alectsnodgrass/Project-HELIOS/README.md

# **Project HELIOS**

> [!NOTE]
> Project HELIOS takes its name from Helios, the Greek personification of the Sun. In ancient mythology, Helios commanded a magnificent chariot of fire, drawn by four powerful horses, carrying the Sun across the heavens each day.
> 
> His legendary journey symbolizes the union of solar energy, power, and motion. Just as Helios harnessed the power of the Sun to drive his celestial chariot, Project HELIOS seeks to harness solar energy to power modern vehicles.
HELIOS

# Executive Summary

### Elevator Pitch

Project HELIOS transformed an incomplete, nonoperational golf cart into a working platform for evaluating solar-assisted electric transportation. In partnership with LANI-EV, a division of LANI-Solar, the team restored Tennessee Tech’s Club Car, integrated a lithium iron phosphate battery and solar-charging system, and evaluated how solar energy replenishes the battery relative to vehicle energy use. The project also produced an adaptable solar-panel mounting kit and a simulated four-servo control concept that directs the panel toward the sun while the cart is parked. Together, these outcomes provide practical designs, performance evidence, and repeatable documentation to support future solar-powered vehicle retrofits.

### Abstract

Solar-assisted low-speed vehicles offer an opportunity to supplement grid charging with onboard renewable energy. Their practical value depends on reliable integration, adaptable mounting hardware, and an understanding of how solar generation compares with vehicle energy demand. Working with LANI-EV, Tennessee Technological University’s Electrical and Computer Engineering Project HELIOS addressed these challenges through vehicle restoration, retrofit implementation, performance testing, and control-system design.

The team restored an inherited Club Car that arrived partially disassembled and without batteries or a steering wheel. A lithium iron phosphate battery and solar-charging system were integrated, supported by an illustrated conversion procedure, as-built electrical documentation, and installation records. Post-conversion testing characterized solar charging and vehicle discharge under documented operating conditions, providing an evidence-based assessment of the system’s energy balance.

To improve installation adaptability, the team surveyed roof configurations across three major vehicle brands and developed a functional mounting-kit prototype designed to accommodate selected models from at least two brands. The team also developed and evaluated a concept for parked-vehicle solar tracking. Using vehicle-state, solar optics, and position tracking the algorithm generated coordinated commands for four servos within a modeled range of panel motion. Simulation evaluated orientation calculations, operating-state transitions, and responses to invalid inputs.

The completed project delivered a restored demonstration vehicle, retrofit documentation, performance data, a mounting-kit engineering package, and a simulated solar-tracking concept. These deliverables establish a foundation for LANI-EV and future engineering teams to refine solar-assisted vehicle designs and assess their suitability for specific operating conditions.

# Capabilities

The completed project combines a solar-assisted vehicle retrofit, adaptable mounting hardware, and a maximum power point solar-tracking concept.

 - **Operational vehicle platform:** A restored Tennessee Tech Club Car supports demonstration and testing of the LANI-EV solar retrofit.

 - **Solar-assisted battery charging:** A lithium iron phosphate (LiFePO₄) battery and compatible solar-charging system supply vehicle power and replenish stored energy when sunlight is available.

 - **Performance characterization:** Recorded charging and discharge data show how solar input compares with vehicle energy demand under documented operating conditions.

 - **Adaptable panel mounting:** A functional mounting-kit prototype provides a common attachment approach designed for selected models from at least two major vehicle brands. Engineering drawings and installation instructions define its supported configurations.

 - **Simulated solar tracking:** A control algorithm uses vehicle-state, compass-heading, date/time, and geographic-location inputs to calculate panel orientation and generate coordinated commands for four servos. Simulation covers parked-operation logic, motion limits, and invalid-input handling.

 - **Repeatable engineering documentation:** Conversion instructions, wiring diagrams, component records, test procedures, and editable design files support maintenance and future development.

Full-scale powered panel positioning remains a future implementation step. Solar charging supplements the battery’s energy supply; grid-free operation depends on sunlight, driving conditions, and vehicle usage.

# Salient Outcomes

 - Restoration became a substantial engineering contribution. The inherited vehicle arrived disassembled, without batteries or a steering wheel, and with extra, unnecessary components. Establishing a functional test platform required evaluating and restoring the vehicle before completing the retrofit.

 - The project connected solar generation to actual vehicle demand. Charge-versus-discharge testing provided a practical basis for evaluating solar assistance under specific operating conditions.

 - The mounting design addressed more than one vehicle configuration. A three-brand roof survey informed an adaptable kit architecture, with shared components and model-specific interfaces documented for future refinement.

 - Parked time became an opportunity for further design exploration. The tracking concept explored how panel orientation could follow the sun while the vehicle is stationary. 

 - The documentation supports continued development. The project leaves future teams with a traceable record of the vehicle configuration, installation process, test results, and design assumptions.

# Project Demonstration & Images

Give a link to a video of the project being demonstrated. The video should be hosted on the capstone youtube.

# About Us

### Alec Snodgrass 
Alec Snodgrass will graduate Fall 2026 with a B.S. in both in Electrical Engineering and Physics. Serving as the team lead for this capstone project, he is responsible for project management, external communication with the industry sponsor, and oversight of subsystems integration. His prior physics research capstone experience contributes to structured experimental design, data analysis, and methodology development. In addition to managerial responsibilities, he maintains equal technical contribution. His prior military leadership experience informs his organizational approach and accountability standards in managing a multi-member engineering team.

### George Vaporis  
George Vaporis is a senior at Tennessee Technological University, majoring in Electrical Engineering. He is responsible for completing all tasks assigned in a manner of good quality and timeliness. He has previous experience in working in group projects that have involved coding, building, and information gathering and analysis, giving him the necessary experience to complete any tasks assigned for this project.

### Landon Paul  
Landon Paul is a senior majoring in Electrical Engineering, with a minor in Mathematics. As secretary for this project, his responsibilities include documenting and distributing information for each team meeting. While in high school, Landon graduated Summa Cum Laude with an associate degree in Liberal Arts from Austin Peay State University through the dual enrollment program. He began working for his father’s company at age 12, fulfilling projects for customers such as the Country Music Hall of Fame, the Tennessee Titans, and Taylor Swift. While at Tennessee Tech, he has had the privilege to be a tutor, grader, and a teacher’s assistant.

### Nathan Galloway 
Nathan Galloway is a senior at Tennessee Technological University pursuing a Bachelor of Science in Electrical Engineering with a concentration in power systems. Throughout his academic career, Nathan has developed a strong foundation in power analysis, programming, and hands-on electrical systems work; skills he will bring directly over to this project. In his role, Nathan will be responsible for collecting and analyzing project data, then synthesizing his findings into a clear, well-organized, and professional document. He will also contribute to the hands-on restoration of the golf car, working to return it to fully operational condition.

### Parker Branson
Parker Branson is a senior in Electrical Engineering and has an associate's degree in mathematics and physics. My main focus is in power systems and my contribution to the project will be to bring in knowlege to the team to help complet task and while ensuring to carry my full share of the responsibilities we take on as a group and also hands on work with the golf car. Parker is experienced in electrical wiring, Excel, C++, soldering, and LTspice. 

---

## Faculty Supervisor -- Dr. Charles Van Neste

| Field | Information |
|---|---|
| **Title** | Associate Professor |
| **Department** | Electrical and Computer Engineering |
| **Office** | Prescott Hall (PRSC) 407 |
| **Email** | cvanneste@tntech.edu |
| **Phone** | (931) 372-3682 |

### Research Areas and Interests

| Research Area |
|---------------|
| Alternative forms of energy generation and transmission (wireless and quasi-wireless power transfer) |
| High frequency inverter design |
| Electronic instrumentation |
| Electromagnetic interactions |

### Educational Background

| Degree / Position | Institution | Year | Notes |
|---|---|---|---|
| Postdoctoral Research | Oak Ridge National Laboratory | 2010 | Photonics |
| Ph.D. Electrical Engineering | Tennessee Tech University / ORNL | 2009 | Thesis: *The Sound of Light: An open environment photoacoustic identification of surface adsorbed molecules* |
| M.S. Electrical Engineering | Tennessee Tech University / ORNL | 2006 | Research Assistantship |
| B.S. Electrical Engineering | Tennessee Tech University | 2004 | Undergraduate |

---

## Stakeholders
The primary customer for this project is Lani Electric Vehicles (LaniEV), a subsidiary of Lani Solar, LLC. Lani Solar develops solar-integrated mobility platforms and energy solutions intended to reduce grid dependence and lifecycle operating costs in light electric vehicle applications. LaniEV is developing standardized retrofit conversion kits for low-speed electric vehicles (LSVs), personal transportation vehicles (PTVs), and golf cars that replace legacy lead-acid battery systems with LiFePO₄ battery banks integrated with solar charging capability. The company’s objective is to enable scalable fleet conversions by providing a structured and repeatable retrofit platform supported by validated engineering documentation.

Secondary stakeholders include organizations that utilize LSV fleets, such as golf resorts, hotels, universities, airports, and industrial plants. Organizations such as these rely on LSVs for day-to-day logistics and are directly affected by reliability, lifecycle cost, and maintenance requirements. Formal documentation of the retrofit process and post-conversion performance data provides decision-making support for these stakeholders by enabling informed evaluation of economic and operational impact. Secondary stakeholders also include Tennessee Technological University (TTU), as the owner of the control golf car used for the project, and as the ensuring agency for documented safety, reliability, and performance data. Dr. Christopher Storm Johnson is responsible, as the capstone instructor, for evaluating team performance and ensuring the project's desired end-state is reached.

---

# Repo Organization

### 1. Reports

    Poster Template
    Report Figures
    0. Team 6 Contract
    1. Project Proposal Specification
    2. Conceptual Design Specifications
    3. Detailed Design Specifications
    4. Design Presentation Specifications
    5. Experimental Analysis Specifications
    6. Individual Presentation Specifications
    7. Final Presentation Specifications
    8. Final Poster Specifications

### 2. Documentation

    0. Project Details
        - Club Car Manuals
        - Rubrics
        - Standards
        - Team 1 Project Outline
        - Team 6 Project Outline
        - Project Timeline
    1. Photos
        - 0. Initial State of LSV
        - 1. Conversion Process
        - 2. Post-conversion
    2. Electrical
        - PCB
        - Schematics
    3. Software
    4. Mechanical
        - CAD Parts
        - Cad Assemblies
        - Chinese Drawings

### 3. Meeting Minutes

    Meeting Minutes Week 1
    Meeting Minutes Week 2
    Meeting Minutes Week 3
    Meeting Minutes Week 4
    Meeting Minutes Week 5
    Meeting Minutes Week 6
    Meeting Minutes Week 7
    Meeting Minutes Week 8
    Meeting Minutes Week 9
    Meeting Minutes Week 10
    Meeting Minutes Week 11
    Meeting Minutes Week 12
    Meeting Minutes Week 13
    Meeting Minutes Week 14
    Meeting Minutes Week 15
    Meeting Minutes Week 16
    Meeting Minutes Week 17
    Meeting Minutes Week 18
    Meeting Minutes Week 19
    Meeting Minutes Week 20
    Meeting Minutes Week 21
    Meeting Minutes Week 22
