alectsnodgrass/Project-HELIOS/2. Documentation/3. Software/Solar_Tracker/tinkercad.md

# Circuit Design for Solar Tracker

[Tinkercad](https://www.tinkercad.com/things/2MzcQUdWTNI-solar-tracking-code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)
