alectsnodgrass/Project-HELIOS/2. Documentation/0. Project Details/Team 1 Project Outline/Team1_Original Project Specs.pdf

TTU Capstone Project Write-Up

Proposed Project Title: Integrated Solar Power System for Low-Speed Vehicles (LSVs): Advancing Technology, Economics, and Design

Proposed Starting Semester: Spring Semester January 16, 2026.

Introduction and Motivation (Project Purpose: Describe problem/opportunity with current product or situation)

This capstone project, in collaboration with Lani EV, LLC, aims to accelerate the transition of Low-Speed Vehicles (LSVs) toward self-sustaining solar power. As the LSV market seeks greater operational efficiency and sustainability, this study addresses four critical areas: advanced solar technology feasibility, economic validation, engineering design, and battery management system integration. The findings will provide objective, data-driven validation for a new generation of solar-powered LSVs.

Alignment with TTU Research

The central hypothesis is that this unit can sustain operation for several weeks without requiring grid-based charging via the on-board charger. We therefore seek independent, objective evaluation and analysis to validate this claim. Furthermore, we hypothesize that the societal benefits of this technology—such as reducing strain on the electrical grid and lowering carbon emissions—will translate into measurable economic gains. The research expertise of Tennessee Tech University is essential to rigorously quantify these environmental and societal impacts.

The successful project will provide the candidate with experience in applying the scientific method to a real-world engineering problem. The candidate will be responsible for defining the critical performance metrics and designing the experimental protocol for measurement and documentation. This work requires developing both qualitative and quantitative methods to compare the operational characteristics of gas versus solar/battery power sources.

A primary output will be documentation showing the solar cart’s self-sustaining capability under average daylight conditions. Specifically, a detailed data table will be required to plot the LiFePO4 battery's charge and discharge rates across varying solar irradiance (measured in foot-candles or W/m2) and corresponding motor amp draw (representing speed and load)

Project Objectives (Summary) (Goals and Objectives: What must the product or research achieve? What are the project objectives and specifications for the final product / process?)

Comparative Economic & Performance Analysis: Quantify the life-cycle cost savings and document the operational performance (range, efficiency) of solar-powered carts vs. gas and traditional electric carts.

Universal Solar Panel Attachment Kit Development: Design, model, and prototype a non-invasive, universal kit to adapt solar panels to major name-brand LSV roofs.

Solar Integration and BMS Investigation: Study the dynamic interaction and impact of continuous solar charging on the Battery Management System (BMS) of a LiFePO₄ battery.

Advanced Solar Technology Feasibility: Evaluate and model the application of next-generation solar cells (TOPCon, Perovskite) and flexible PV (Photovoltaic) on LSVs to determine efficiency gains over standard PV.

Deliverables

Comprehensive White Paper: A final report detailing the methodology, data, conclusions, and recommendations across all four objectives.

Engineering Package: Computer-Aided Design (CAD) files, engineering drawings, and a fabricated prototype of the universal attachment kit (O3).

Performance Data Logs: Raw and summarized data on solar charging dynamics, comparative cart performance, and LiFePO₄ BMS parameters (O2 & O4).

Economic Analysis Report: Detailed cost-savings analysis and return on investment (ROI) calculation (O2).

Goal 1: Comparative Economic & Performance Analysis

Objective: To establish a verifiable baseline for the economic and operational advantages of a solar cart over traditional electric and gas-powered LSVs across varied conditions and terrains.

Goal Description | Deliverable
G1.1 - Cost Baseline Development: Quantify and compare the initial investment, maintenance, and operational costs (e.g., fuel/electricity cost per mile, labor for refueling) for solar, electric, and gas carts. | Full Life-Cycle Cost Comparison Table.
G1.2 - Range Testing Methodology: Develop a rigorous methodology to measure the distance a solar-charged battery can travel until a defined depletion point under diverse terrains (flat, hilly) and environmental conditions. | Detailed Test Protocol (Methodology Section).
G1.3 - Performance Documentation: Execute the methodology (G1.2) and document key | Comparative Performance Graphs.

performance metrics, including Cost Per Mile and Energy Consumption Per Mile, for all three cart types.

G1.4 - Economic ROI Analysis: Document and analyze the baseline cost savings and calculate the Return on Investment (ROI) timeframe for the solar cart compared to the alternatives. | Economic Savings White Paper Section.

Goal 2: Advanced Solar Technology Feasibility & Application

Objective: To examine the efficacy of the most recent advanced solar applications (e.g., TOPCon, Perovskite, Smart Panels, Flexible PV) and determine their technical and efficiency benefits when applied to Low-Speed Vehicles (LSVs).

Goal Description | Deliverable
G2.1- Literature Review: Conduct a comprehensive review of the latest solar cell technologies (TOPCon, Perovskite Tandem Cells, Smart Panels with Microinverters) focusing on power density, conversion efficiency, and cost per watt. | Research Report on Advanced Solar PV.
G2.2 - Efficiency Gap Analysis: Quantify the theoretical efficiency increase of these advanced technologies compared to standard Photovoltaic (PV) cells relevant to the LSV application. | Comparative Efficiency Data Table.
G2.3 - Flexible PV Testing: Design and execute bench testing to measure the charge contribution (Delta V charge) of a flexible solar application to a specified battery (e.g., LiFePO₄) under controlled light and temperature conditions. | Flexible Solar Performance Data Log.
G2.4 - LSV Application Modeling: Develop a simulation model applying the findings (G1.2) to an LSV, estimating the resulting increase in range or decrease in grid charging frequency. | Applied LSV Performance Model.

Goal 3: Universal Solar Panel Attachment Kit Development

Objective: To design and prototype a universal, non-invasive attachment mechanism (kit) that allows a solar panel to be reliably and aesthetically fitted to multiple major brand LSVs (e.g., EZ GO, Yamaha).

Goal Description | Deliverable
G3.1- Design Requirements Definition: Survey and document the dimensional and structural specifications (e.g., roof size, mounting points, material) of the top three name-brand LSV roofs (e.g., EZ GO, Yamaha, Club Car). | LSV Roof Specification Matrix.
G3.2 - Universal Design Concept: Develop a CAD model of a solar panel mounting kit that can be adapted to fit at least two different name-brand LSVs while prioritizing non-invasive installation and aerodynamic stability. | CAD Design Renders and Part List.
G3.3 - Prototype Fabrication: Fabricate a functional prototype of the universal attachment kit using suitable materials. | Physical Prototype Kit.
G3.4 - Installation Manual: Document the installation process for the attachment kit, providing clear instructions for adaptability across different models. | Engineering Drawings and Installation Guide.

Goal 4: Solar Integration and Battery Management System (BMS) Investigation

Objective: To investigate the interface between solar charging and the Battery Management System (BMS) of a LiFePO₄ battery, assessing how a solar roof manages the charge and its overall impact on battery health.

Goal Description | Deliverable
G4.1- BMS Communication Analysis: Document the specific charge management protocols (e.g., float voltage, cutoff parameters) and data communication methods used by the existing solar charge controller and the LiFePO₄ BMS. | System Integration Diagram and Protocol Summary.
G4.2 - Controlled Charge Impact Study: Conduct a long-term (e.g., 30-day) study | Long-Term Battery Health Data.

where a LiFePO₄ battery is continuously solar-charged. Monitor and document key BMS parameters (e.g., cell balancing, temperature, State of Health (SOH)) versus a baseline battery.

G4.3 - Battery Technology Forecast: Research and document the latest technical battery advances (e.g., solid-state, next-gen Li-ion) and provide a technical forecast on how they will interact with or necessitate changes to the solar roof's charge management system. | Technical Forecast Report.
G4.4 - Optimal Integration Recommendation: Based on findings, provide a set of recommendations for optimizing the solar charge controller settings to maximize battery life and performance. | Integration Recommendation Summary.

Conclusion

This capstone project outlines a symbiotic partnership between Lani EV, LLC and Tennessee Tech University, designed to rigorously quantify the real-world performance, economic viability, and societal impact of a novel solar-powered low-speed vehicle.

For the TTU capstone candidate, this project offers an exceptional opportunity to apply the scientific method and advanced engineering principles to a tangible, real-world challenge. The candidate will gain direct experience in experimental design, data analysis, and the
development of both qualitative and quantitative metrics, while also building upon the research foundation of previous TTU capstone projects.

For Lani EV, LLC this collaboration provides the critical, independent validation necessary to move the assessment of this technology from an internal hypothesis to an objectively verified fact. The resulting data will be transformative, providing objective proof (or disproval) of the solar cart's extended operational efficiency, its return on investment, and its potential as a transformative, attainable benefit to society.

We are confident that this study will yield significant insights, culminating in a comprehensive white paper that details technology’s true capabilities. We look forward to collaborating with Tennessee Tech University to execute this timely and impactful research.

Components Needed for Hypothesis Validation and Self-Sustaining Capability Demonstration (Grok.com)

To validate the central hypothesis (sustained operation for weeks without grid charging) and produce the required documentation (e.g., data tables plotting LiFePO4 battery charge/discharge rates vs. solar irradiance and motor amp draw), the following core components are essential for setup, testing, and data collection. These enable experimental protocols comparing gas vs. solar/battery power sources under average daylight conditions.

Solar-Powered LSV Base System:

Low-Speed Vehicle (LSV) or golf cart chassis (e.g., 36V or 48V system, compatible with major brands like EZGO, Club Car, Yamaha).

LiFePO4 battery pack (e.g., 100Ah or higher capacity, with built-in or external BMS for safe charging/discharging).

Solar panels (standard monocrystalline or polycrystalline PV, 100W–410W rating, flexible for roof mounting to simulate real-world integration).

MPPT solar charge controller (to optimize continuous solar input and prevent overcharging).

Electric motor and controller (brushless DC type, rated for variable speeds and loads).

Wiring harness, fuses, and connectors (for integrating solar input to battery and motor).

Measurement and Data Logging Tools:

Solar irradiance meter (e.g., Fluke IRR1-SOL or REED R8180, measuring in W/m² or foot-candles up to 2000 W/m²).

Clamp meter or multimeter (e.g., Fluke models for amp draw, voltage, and current monitoring during motor operation and battery cycles).

Battery monitoring sensors (voltage, current, temperature probes to track charge/discharge rates and BMS parameters).

Data logger (e.g., portable USB or Bluetooth-enabled device for real-time logging of irradiance, amp draw, and battery metrics over extended periods).

Pyranometer (for precise solar radiation measurement in outdoor tests).

Comparative Test Vehicles:

Gas-powered cart (e.g., standard gasoline engine model for baseline performance metrics like fuel consumption and range).

Traditional electric cart (grid-charged, with lead-acid or basic lithium batteries for efficiency and range comparison).

These components allow qualitative (e.g., operational observations) and quantitative (e.g., efficiency calculations) methods, with data outputs for tables and plots.

Components for Objective 1: Comparative Economic & Performance Analysis

To quantify life-cycle cost savings, range, and efficiency of solar-powered carts vs. gas and traditional electric carts, additional specialized items are needed beyond the base system.

Performance Testing Equipment:

Odometer or GPS tracker (for measuring range under varying loads and speeds).

Energy consumption meter (e.g., for kWh usage in electric/solar vs. fuel volume in gas carts).

Dynamometer or load simulator (to mimic real-world speeds and inclines for amp draw and efficiency tests).

Economic Analysis Tools:

Spreadsheet software or dedicated modeling tools (e.g., Excel with add-ins for ROI calculations, incorporating fuel/electricity costs, maintenance, and carbon emissions data).

Environmental sensors (e.g., CO2 emission analyzer for gas carts to quantify carbon footprint mitigation).

This setup supports side-by-side field evaluations, showing solar carts can extend range by 3–7 miles per charge and reduce energy use by up to 20% annually compared to grid-electric or gas models.

Components for Objective 2: Universal Solar Panel Attachment Kit Development

For designing, modeling, and prototyping a non-invasive, universal kit adaptable to major LSV roofs.

Design and Modeling Tools:

CAD software (e.g., SolidWorks or AutoCAD for creating drawings and 3D models).

3D printer or CNC machine (for rapid prototyping of custom parts).

Hardware Components for Prototype:

Z-brackets or L-brackets (aluminum or steel, with nuts, bolts, and washers for secure mounting).

Adjustable clamps or crab mounts (non-drilling type for roof rails or crossbars, compatible with curved or flat LSV roofs).

Tilt legs or adjustable rails (e.g., 58-inch foldable mounts for angle optimization).

Adapters and spacers (rubber or foam padding to fit brands like EZGO, Club Car, or Bintelli without damage).

Fasteners and hardware kit (M6 hex cap bolts, screws, and anti-vibration mounts).

The kit emphasizes ease of installation, with all parts included for roof/wall mounting, ensuring compatibility across vehicle types.

Components for Objective 3: Solar Integration and BMS Investigation

To study the dynamic interaction of continuous solar charging on LiFePO4 BMS.

Battery and Charging System:

LiFePO4 battery cells (individual or pack, e.g., 3.2V cells in series for 12V–48V configurations).

Dedicated BMS module (with overcharge/overdischarge protection, current monitoring, and temperature sensors).

Continuous solar charger (e.g., PWM or MPPT controller simulating daylight input).

Monitoring and Testing Tools:

Oscilloscope or power analyzer (to observe voltage drops, current fluctuations, and BMS responses during charging).

Thermal imager (e.g., Fluke model to detect overheating risks from constant 14.4V input).

Cycle tester (for repeated charge/discharge simulations to assess lifespan impact).

Components ensure safe operation, preventing issues like overcurrent or imbalance, with data showing efficiencies up to 98% in solar setups.

Components for Objective 4: Advanced Solar Technology Feasibility

To evaluate and model next-generation solar cells (TOPCon, Perovskite, flexible PV) on LSVs for efficiency gains over standard PV.

Advanced Solar Panels:

TOPCon solar cells (high-efficiency silicon-based, for baseline comparisons).

Perovskite solar cells (tandem or standalone, lightweight and flexible for vehicle integration).

Flexible PV modules (e.g., CIGS or thin-film, bendable for curved roofs).

Evaluation Tools:

Efficiency tester (e.g., solar simulator or outdoor irradiance setup to measure power conversion up to 31%).

Modeling software (e.g., PVsyst or MATLAB for simulating gains, predicting 10–30% improvements over standard PV).

Mounting adapters (to test integration on LSV roofs without permanent changes).

These enable modeling of real-world applications, highlighting perovskite's potential for lightweight, high-efficiency (up to 31%) flexible cells.

Additional Resources for Deliverables

Documentation and Reporting Tools: Word processors or LaTeX for white papers; data visualization software (e.g., MATLAB, Python with Matplotlib) for charts and logs.

Fabrication Support: Workshop tools (drills, saws) for prototype assembly; raw materials like aluminum sheets for custom brackets.

These components collectively enable rigorous quantification of environmental/societal benefits (e.g., reduced grid strain, lower emissions) and economic advantages (e.g., ROI from 20% energy savings), aligning with Tennessee Tech's research expertise. Procurement should prioritize US-made items where possible for reliability.
