alectsnodgrass/Project-HELIOS/2. Documentation/0. Project Details/Team 1 Project Outline/Team1_Updated Project Specs.pdf

Goal 1: Comparative Economic & Performance Analysis

Objective: To establish a verifiable baseline for the economic and operational advantages of a solar cart over traditional electric and gas-powered LSVs across varied conditions and terrains.
Goal Description | Deliverable
G1.1 - Cost Baseline Development: Quantify and compare the initial investment, maintenance, and operational costs (e.g., fuel/electricity cost per mile, labor for refueling) for solar, electric, and gas carts. | Full Life-Cycle Cost Comparison Table.

G1.2 - Range Testing Methodology: Develop a rigorous methodology to measure the distance a solar-charged battery can travel until a defined depletion point under diverse terrains (flat, hilly) and environmental conditions.

Detailed Test Protocol (Methodology Section).

G1.3 - Performance Documentation: Execute the methodology (G1.2) and document key performance metrics, including Cost Per Mile and Energy Consumption Per Mile, for all three cart types. | Comparative Performance Graphs.
G1.4 - Economic ROI Analysis: Document and analyze the baseline cost savings and calculate the Return on Investment (ROI) timeframe for the solar cart compared to the alternatives. | Economic Savings White Paper Section.

Goal 2: Advanced Solar Technology Feasibility & Application

Objective: To examine the efficacy of the Perovskite and determine its technical and efficiency benefits when applied to Low-Speed Vehicles (LSVs).
Goal Description | Deliverable
G2.1- Literature Review: Conduct a comprehensive review of Perovskite focusing on power density, conversion efficiency, and cost per watt. | Research Report on Perovskite.
G2.2 - Efficiency Gap Analysis: Quantify the theoretical efficiency increase Perovskite. compared to standard Photovoltaic (PV) cells relevant to the LSV application. | Comparative Efficiency Data Table.
G2.3 – Flexible Perovskite Performance Testing: Design and execute bench testing to measure the charge contribution (Delta V charge) of a Flexible Perovskite solar panel to a specified battery (e.g., LiFePO₄) under controlled light and temperature conditions. (Dependent on if Flexible Perovskite can be attained.) | Flexible Perovskite Solar Performance Data Log.
G2.4 - LSV Application Modeling: Develop a simulation model applying the findings (G1.2) to an LSV, estimating the resulting increase in range or decrease in grid charging frequency. | Applied LSV Performance Model.

Goal 3: Electrical Based Improvement for LaniEV’s L2 Solar Cart

Objective: To design and prototype an electrical based improvement for the solar cart, informed by data from Goal 1 and research from Goals 2 and 4.
Goal Description | Deliverable
G3.1- Design Improvement Proposal: Proposed improvement design to LaniEV’s L2 Solar cart and specification for proposed prototype. | Documentation of Proposed Improvement Design by End of Spring Semester. Design Specification and Required Materials/Components.
G3.2 – Software Design Models and Testing: Software modeling and preliminary test results | Software Engineering Models and Design Renders (Software Type TBD). Preliminary Test Results Supporting the Proposed Improvement.
G3.3 – Conditional Prototype Fabrication: Fabricate a functional prototype of the proposed design improvements using suitable materials. | Prototype of the Proposed Design Improvements if Possible Given time Constraints.
G3.4 – Conclusion Report: Documentation of prototyping results and conclusions. | Final Report of Concluding Results of Prototyping.

Goal 4: Solar Integration and Battery Management System (BMS) Investigation

Objective: To investigate the interface between solar charging and the Battery Management System (BMS) of a LiFePO₄ battery, assessing how a solar roof manages the charge and its overall impact on battery health.
Goal Description | Deliverable
G4.1- BMS Communication Analysis: Document the specific charge management protocols (e.g., float voltage, cutoff parameters) and data communication methods used by the existing solar charge controller and the LiFePO₄ BMS. | System Integration Diagram and Protocol Summary.
G4.2 - Controlled Charge Impact Study: Conduct a long-term (e.g., 30-day) study where a LiFePO₄ battery is continuously solar charged. Monitor and document key BMS parameters (e.g., cell balancing, temperature, State of Health (SOH)) versus a baseline battery. | Long-Term Battery Health Data.
G4.3 - Battery Technology Forecast: Research and document the latest technical battery advances (e.g., solid-state, next-gen Li-ion) and provide a technical forecast on how they will interact with or necessitate changes to the solar roof's charge management system. | Technical Forecast Report.
G4.4 - Optimal Integration Recommendation: Based on findings, provide a set of recommendations for optimizing the solar charge controller settings to maximize battery life and performance. | Integration Recommendation Summary.
