alectsnodgrass/Project-HELIOS/2. Documentation/2. Electrical/Charging Analysis/Charging_Analysis_figure4.png

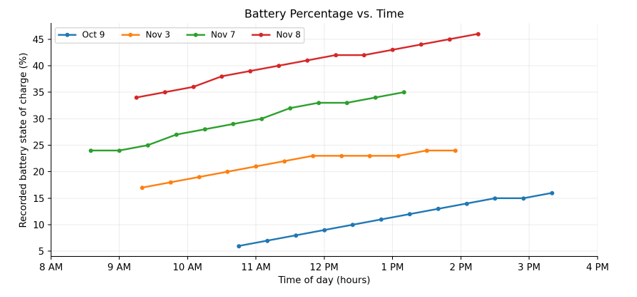
2. Documentation/2. Electrical/Charging Analysis/Charging_Analysis_figure4.png
