alectsnodgrass/Project-HELIOS/2. Documentation/3. Software/Solar_Tracker/x_sensor_numerical_preview.png

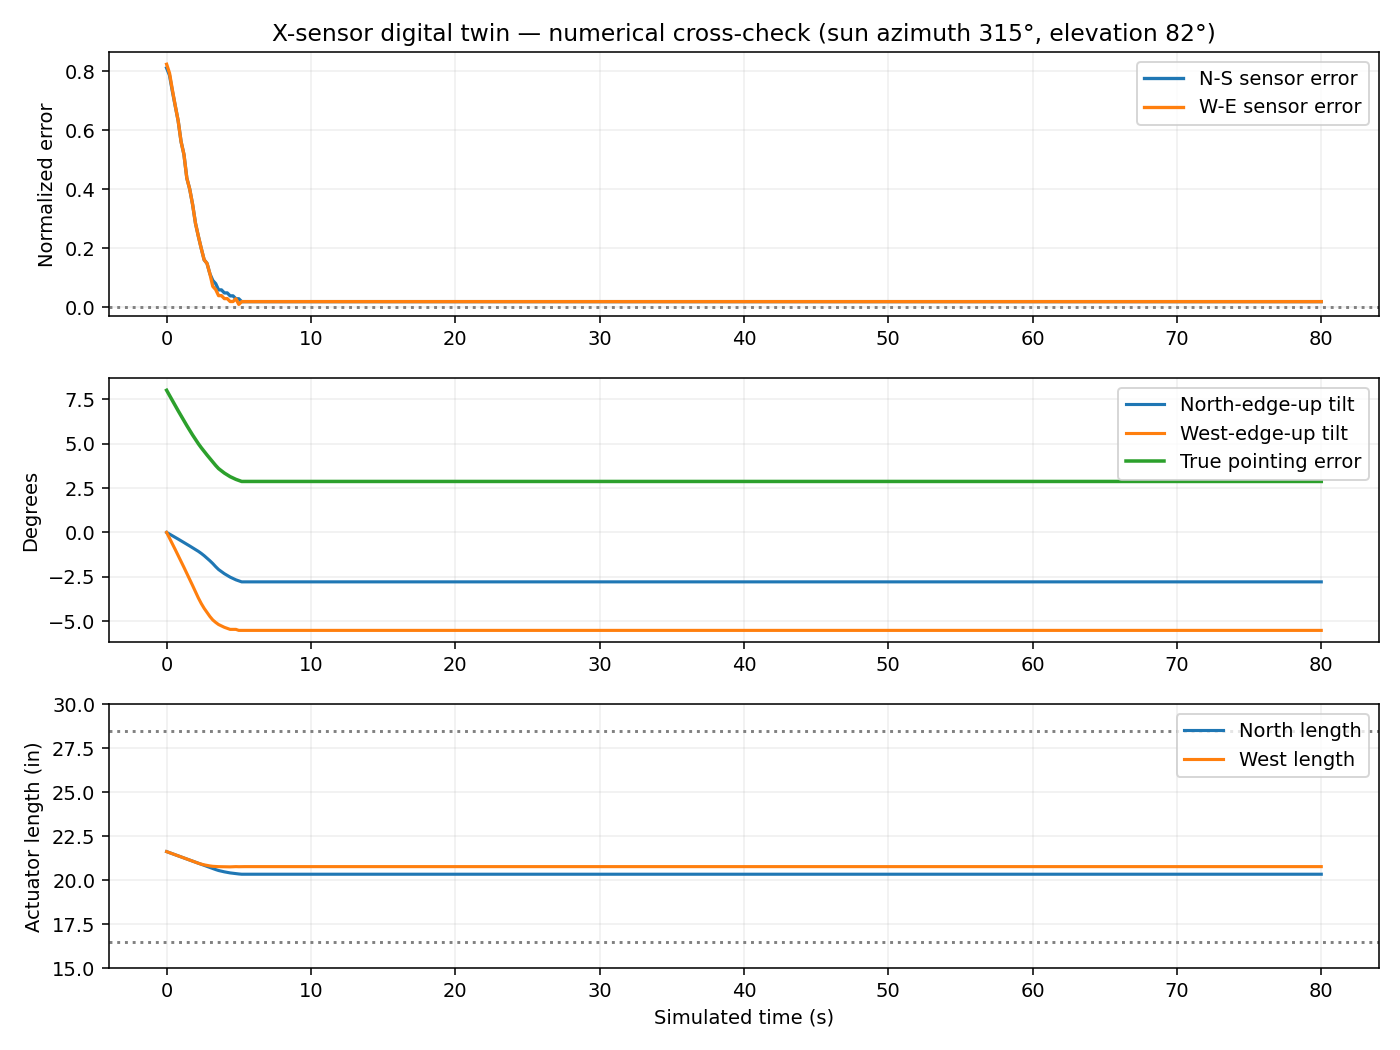
2. Documentation/3. Software/Solar_Tracker/x_sensor_numerical_preview.png
