alectsnodgrass/Project-HELIOS/2. Documentation/4. Mechanical/Cart Model/Golf Cart.png

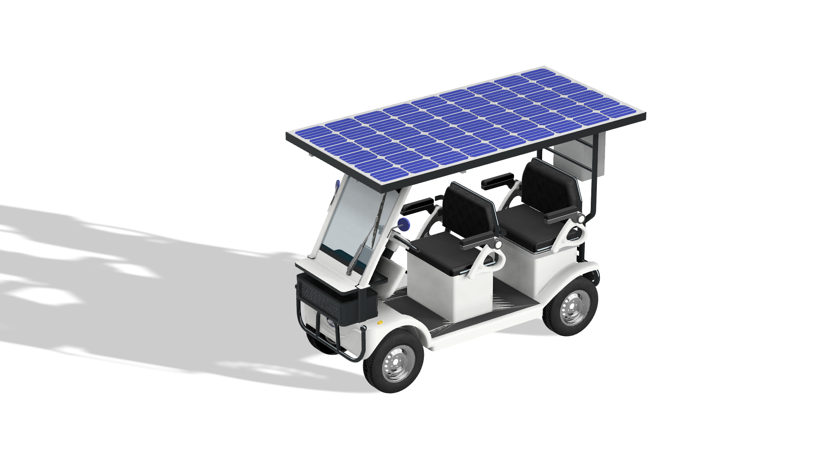
2. Documentation/4. Mechanical/Cart Model/Golf Cart.png
