alectsnodgrass/Project-HELIOS/1. Reports/Solar_Panel_BOM.png

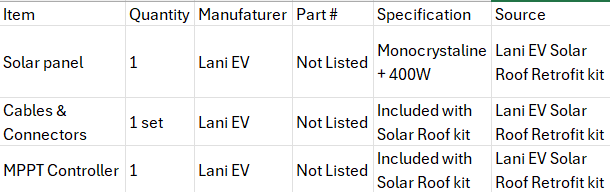
1. Reports/Solar_Panel_BOM.png
