alectsnodgrass/Project-HELIOS/2. Documentation/4. Mechanical/CAD Assemblies/Panel_Frame.SLDASM

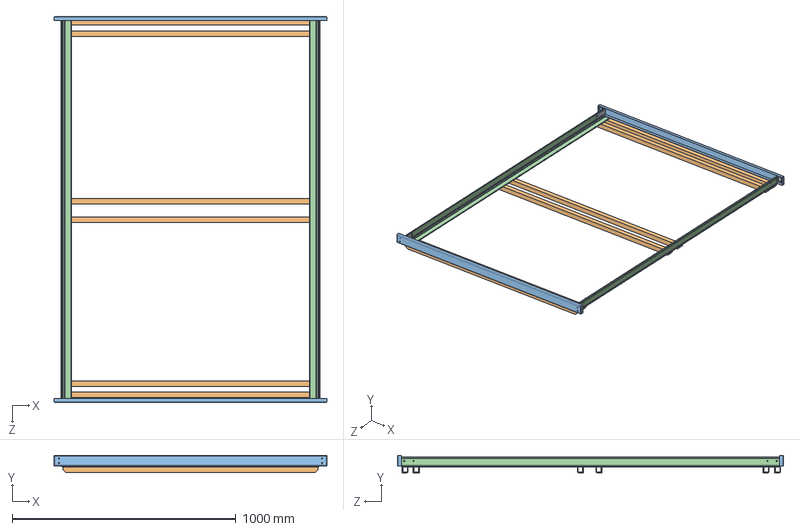
[picture p15: CAD file, 2026-11-12]
2. Documentation/4. Mechanical/CAD Assemblies/Panel_Frame.SLDASM
1219.2 x 77.0 x 1723.9 mm
Side_L_Bracket x 2
Front&Back x 2
CrossBars x 6
Side2Front_Bracket x 4
