alectsnodgrass/Project-HELIOS/2. Documentation/4. Mechanical/CAD Parts/Side_L_Bracket.SLDPRT

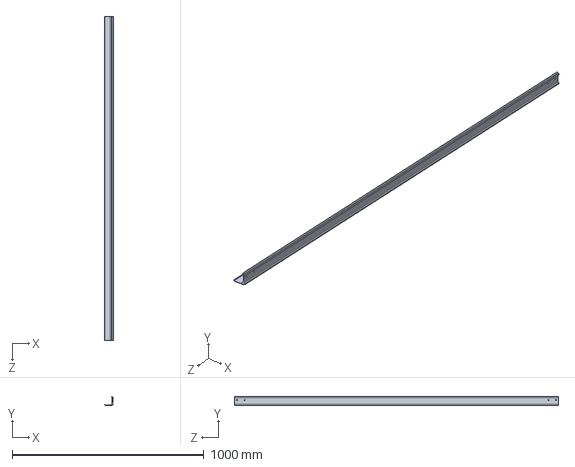
[picture p16: CAD file, 2026-10-24]
2. Documentation/4. Mechanical/CAD Parts/Side_L_Bracket.SLDPRT
46.7 x 44.5 x 1689.1 mm
