alectsnodgrass/Project-HELIOS/2. Documentation/4. Mechanical/CAD Parts/Side2Front_Bracket.SLDPRT

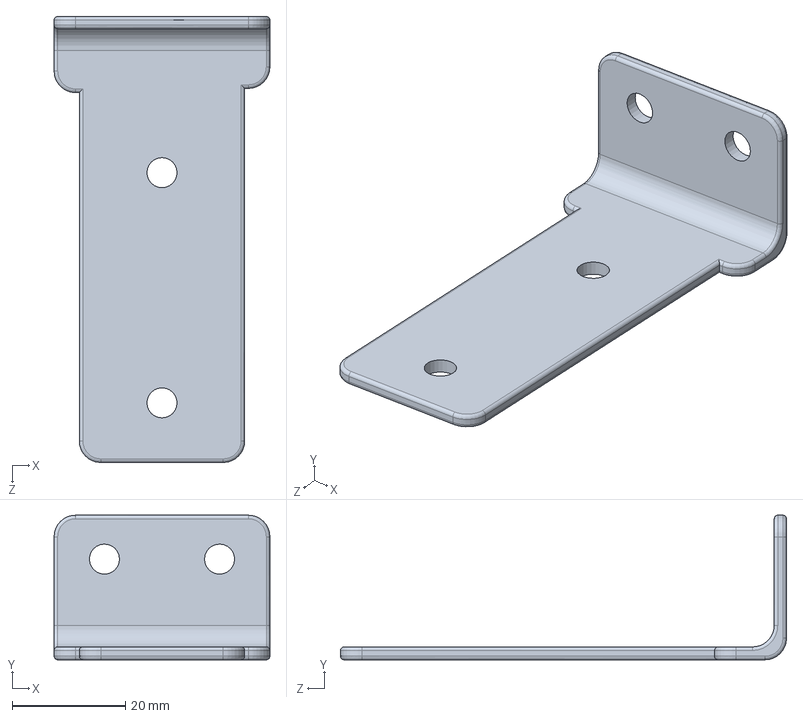
[picture p17: CAD file, 2026-10-24]
2. Documentation/4. Mechanical/CAD Parts/Side2Front_Bracket.SLDPRT
38.1 x 25.5 x 78.7 mm
