alectsnodgrass/Project-HELIOS/2. Documentation/4. Mechanical/CAD Parts/CrossBars.SLDPRT

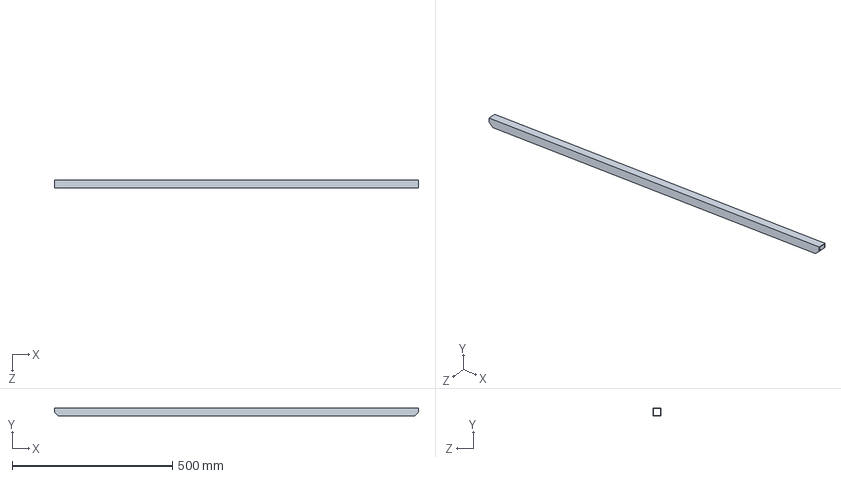
[picture p18: CAD file, 2026-10-24]
2. Documentation/4. Mechanical/CAD Parts/CrossBars.SLDPRT
1136.7 x 25.4 x 25.4 mm
