alectsnodgrass/Project-HELIOS/2. Documentation/4. Mechanical/CAD Parts/Front&Back.SLDPRT

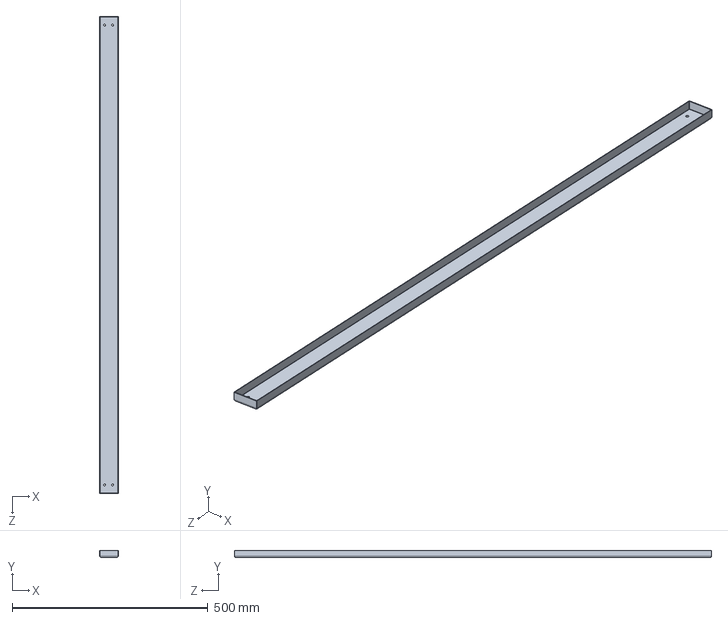
[picture p19: CAD file, 2026-10-24]
2. Documentation/4. Mechanical/CAD Parts/Front&Back.SLDPRT
47.8 x 17.8 x 1219.2 mm
