alectsnodgrass/Project-HELIOS/2. Documentation/4. Mechanical/CAD Assemblies/Frame_Actuators.SLDASM

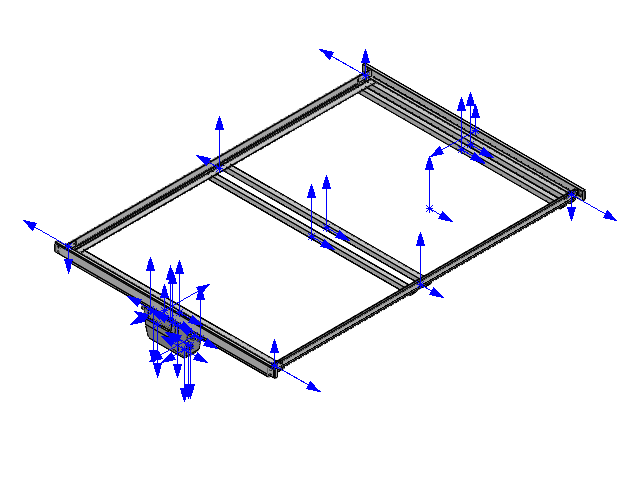
[picture p20: CAD file, 2026-11-12]
2. Documentation/4. Mechanical/CAD Assemblies/Frame_Actuators.SLDASM
Side_L_Bracket x 2
Front&Back x 2
CrossBars x 6
Side2Front_Bracket x 4
535-9223(EXX)
535-9225M
104-9733(B017-100-M)
104-9747(B017-0100)
535-9228-B017--0100-M
434-9085-0100-B017--MA
906-101L141100
954-9364-EXX
