alectsnodgrass/Project-HELIOS/(list of files, cad)

Other CAD files:
2. Documentation/4. Mechanical/Actuator/HD12B017-0100EXX1MMSD.sldasm
2. Documentation/4. Mechanical/Actuator/495-9121.sldprt
2. Documentation/4. Mechanical/Cart Model/Golf Cart with solar panel.step
2. Documentation/4. Mechanical/Actuator/680-9014.sldprt
2. Documentation/4. Mechanical/Actuator/535-9228-B017--0100-M.sldprt
2. Documentation/4. Mechanical/Actuator/495-9120.sldprt
2. Documentation/4. Mechanical/Actuator/954-9364-EXX.sldprt
2. Documentation/4. Mechanical/Actuator/535-9225M.sldprt
2. Documentation/4. Mechanical/Actuator/104-9747(B017-0100).sldprt
2. Documentation/4. Mechanical/Actuator/434-9085-0100-B017--MA.sldprt
2. Documentation/4. Mechanical/Actuator/104-9733(B017-100-M).sldprt
2. Documentation/4. Mechanical/Actuator/906-101L141100.sldprt
2. Documentation/4. Mechanical/Actuator/661-9205.sldprt
2. Documentation/4. Mechanical/Actuator/535-9223(EXX).sldprt
