alectsnodgrass/Project-HELIOS/(commit log)

2026-10-21 Cad Model start
    [CrossBars.SLDPRT, Front&Back.SLDPRT, Roof.SLDASM, Side2Front_Bracket.SLDPRT, Side_L_Bracket.SLDPRT]
2026-10-21 Organized Folders
    [CrossBars.SLDPRT, Front&Back.SLDPRT, Roof.SLDASM, Side2Front_Bracket.SLDPRT, Side_L_Bracket.SLDPRT]
2026-10-24 Assembled Solar Panel Frame
    [CrossBars.SLDPRT, Front&Back.SLDPRT, Roof.SLDASM, Side2Front_Bracket.SLDPRT, Side_L_Bracket.SLDPRT]
2026-11-12 Functional Prototype update
    Not really a "functional Prototype", but since our project lacks much of a design:
    There is an updated "Instal Manual" which serves as our groups record of work performed on the cart
    There are updated CAD Models to show our groups progress on a solar tracking solar panel frame
    I also added the raw data from the charging analsysis
    [104-9733(B017-100-M).sldprt, 104-9747(B017-0100).sldprt, 434-9085-0100-B017--MA.sldprt, 495-9120.sldprt, 495-9121.sldprt, 535-9223(EXX).sldprt, 535-9225M.sldprt, 535-9228-B017--0100-M.sldprt]
2026-11-14 Charging Analysis
2026-11-14 Charging Analysis
    submitting Charging Analysis in correct spot
    [Charging Analysis Data.xlsx]
2026-11-14 Total Prototype
    Prototype video
    Solar Tracking sim + circuit design
    Install manual - updated
    [sample_x_sensor_tracking.csv]
